UoM-Robotics-Society/MEng-Team-Project-Instruments/Final Report/Individual Parts/Josh/DSC_0120.JPG

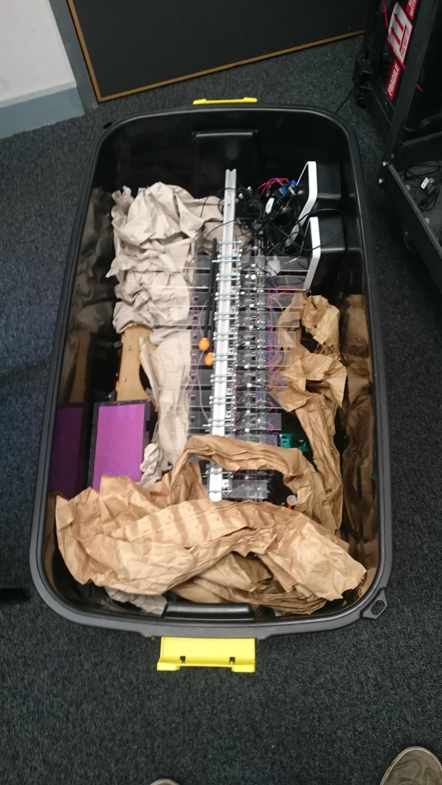
Final Report/Individual Parts/Josh/DSC_0120.JPG
