UoM-Robotics-Society/MEng-Team-Project-Instruments/Interim Report/Figure Source files/Andrei/A4988.PNG

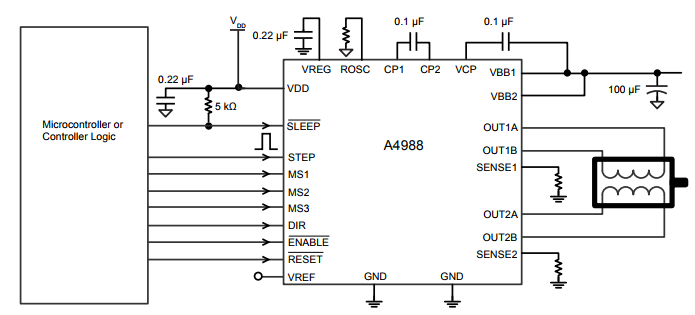
Interim Report/Figure Source files/Andrei/A4988.PNG
