UoM-Robotics-Society/MEng-Team-Project-Instruments/Interim Report/Figure Source files/Francesco/ad9837breakout.PNG

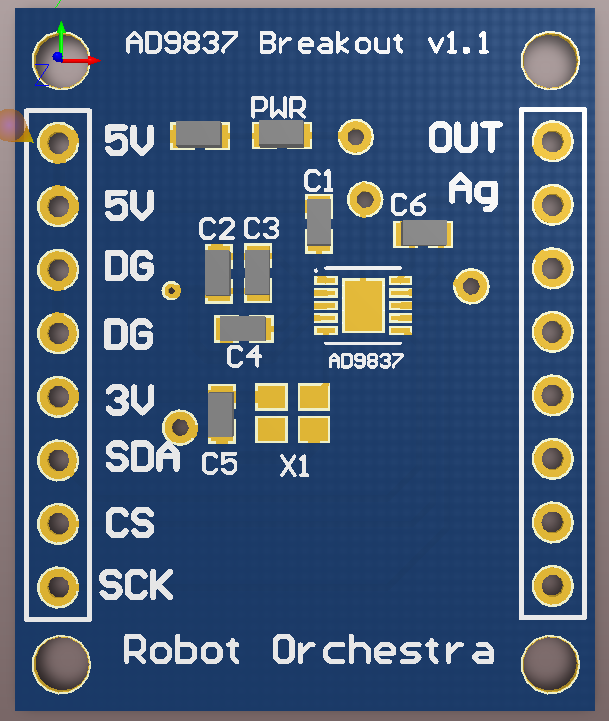
Interim Report/Figure Source files/Francesco/ad9837breakout.PNG
