UoM-Robotics-Society/MEng-Team-Project-Instruments/Interim Report/Figure Source files/Francesco/pcb2.PNG

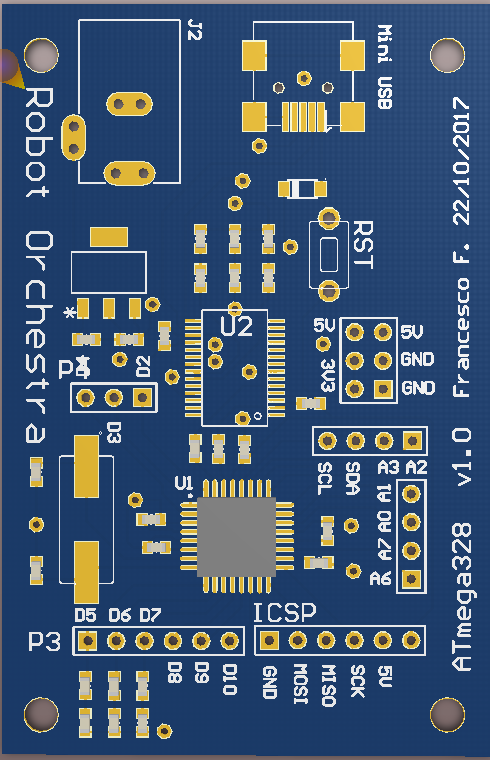
Interim Report/Figure Source files/Francesco/pcb2.PNG
