UoM-Robotics-Society/MEng-Team-Project-Instruments/Interim Report/Figure Source files/Josh/Figure 3.4 Robot playing flute-with lungs.png

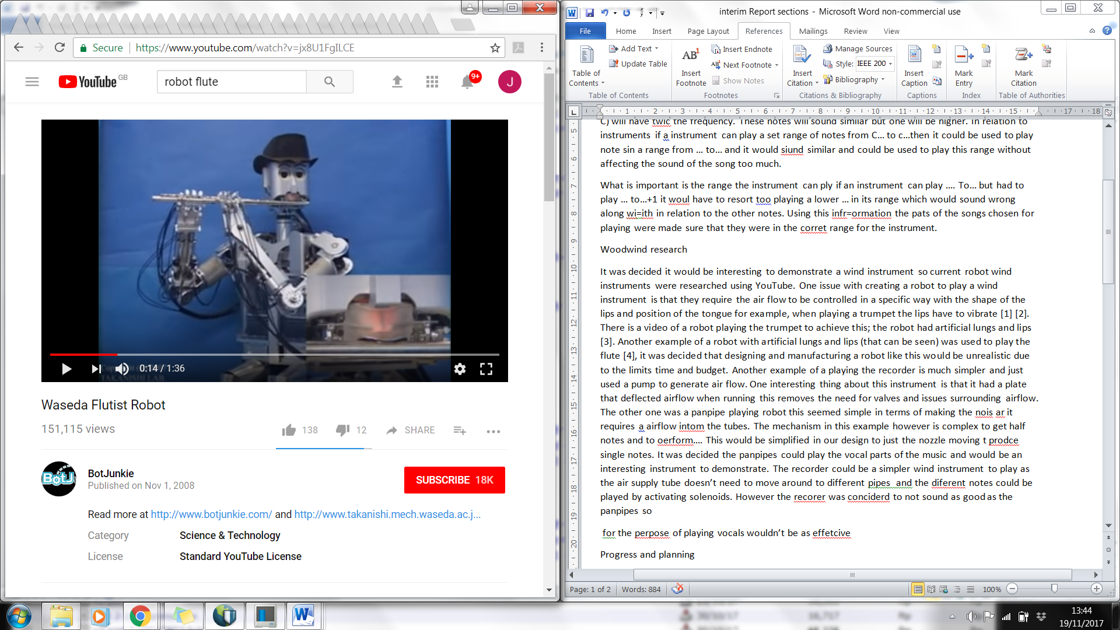
Interim Report/Figure Source files/Josh/Figure 3.4 Robot playing flute-with lungs.png
