UoM-Robotics-Society/MEng-Team-Project-Instruments/Interim Report/Figure Source files/Josh/Figure 3.5 Recorder Fingers.png

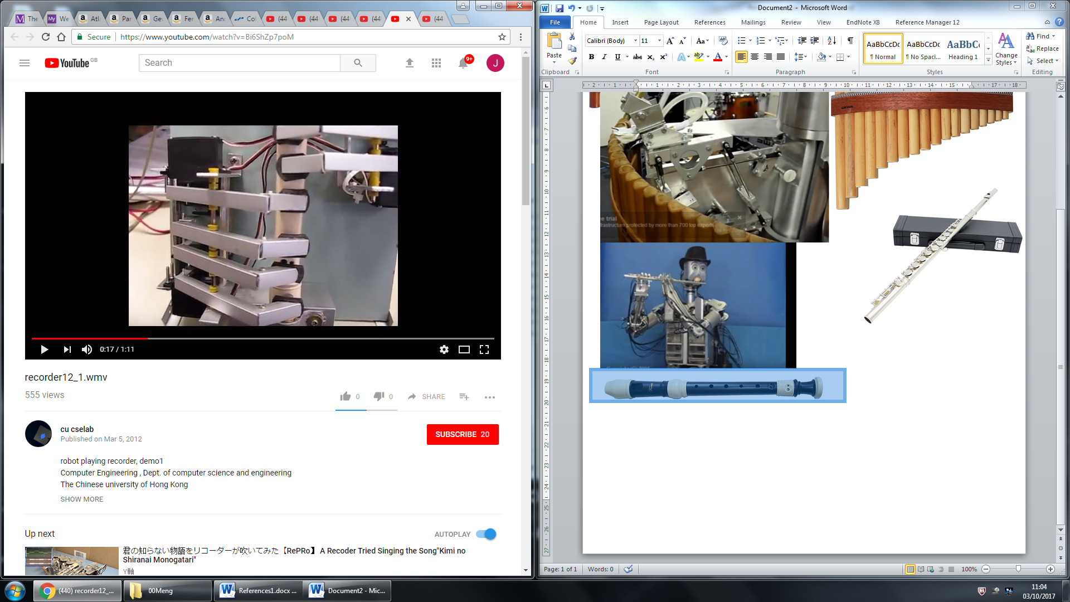
Interim Report/Figure Source files/Josh/Figure 3.5 Recorder Fingers.png
