UoM-Robotics-Society/MEng-Team-Project-Instruments/Interim Report/Figure Source files/Josh/Figure 3.5 Recorder nozzle.png

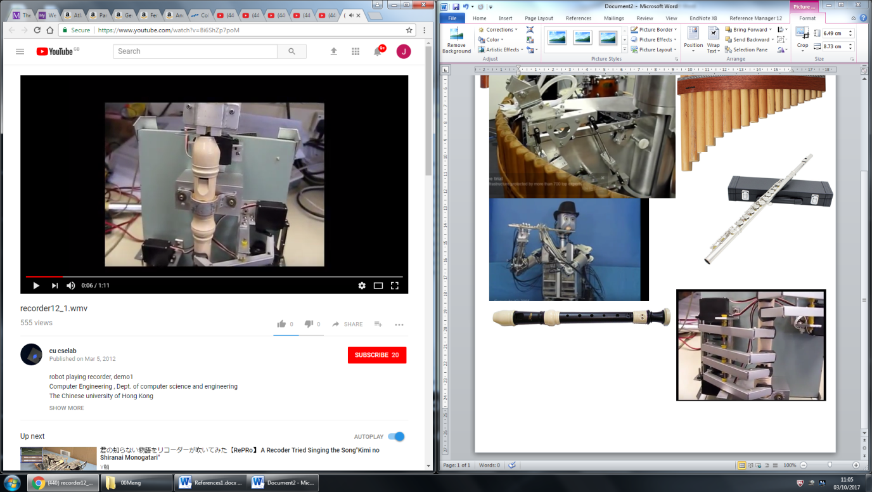
Interim Report/Figure Source files/Josh/Figure 3.5 Recorder nozzle.png
