UoM-Robotics-Society/MEng-Team-Project-Instruments/Interim Report/Figure Source files/Josh/Figure 3.6 Panpipes.png

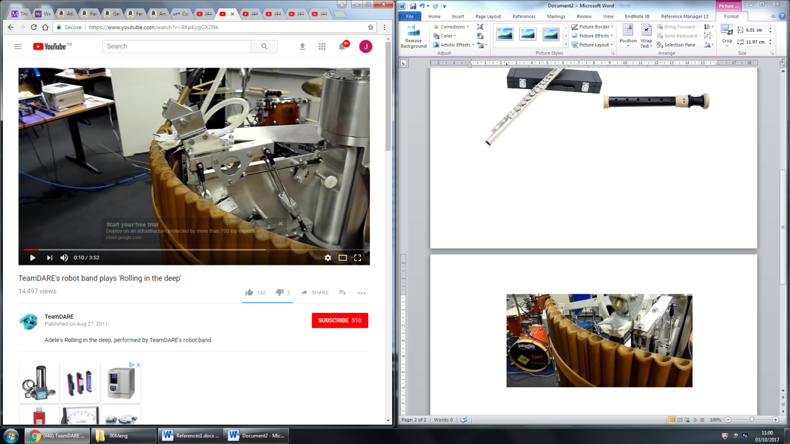
Interim Report/Figure Source files/Josh/Figure 3.6 Panpipes.png
