UoM-Robotics-Society/MEng-Team-Project-Instruments/Interim Report/Figure Source files/Josh/Figure 3.8 left hand image spark gap Tesla.png

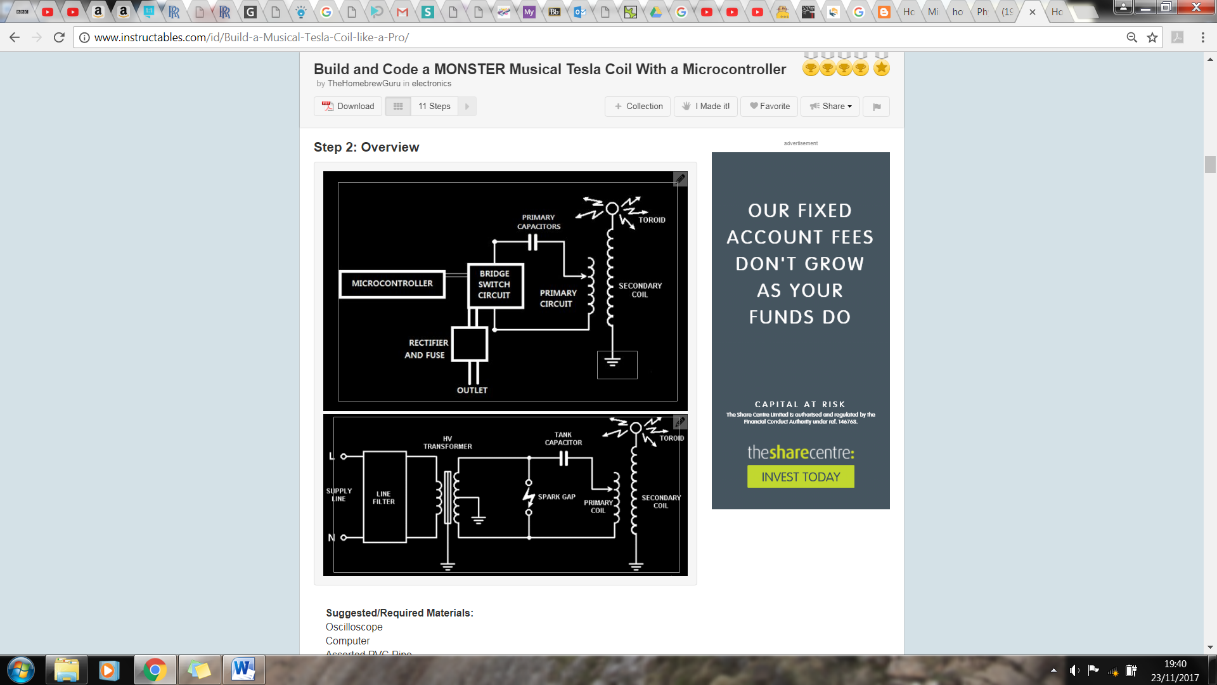
Interim Report/Figure Source files/Josh/Figure 3.8 left hand image spark gap Tesla.png
