UoM-Robotics-Society/MEng-Team-Project-Instruments/Interim Report/Figure Source files/Josh/Figure 3.9 Tesla Coil.png

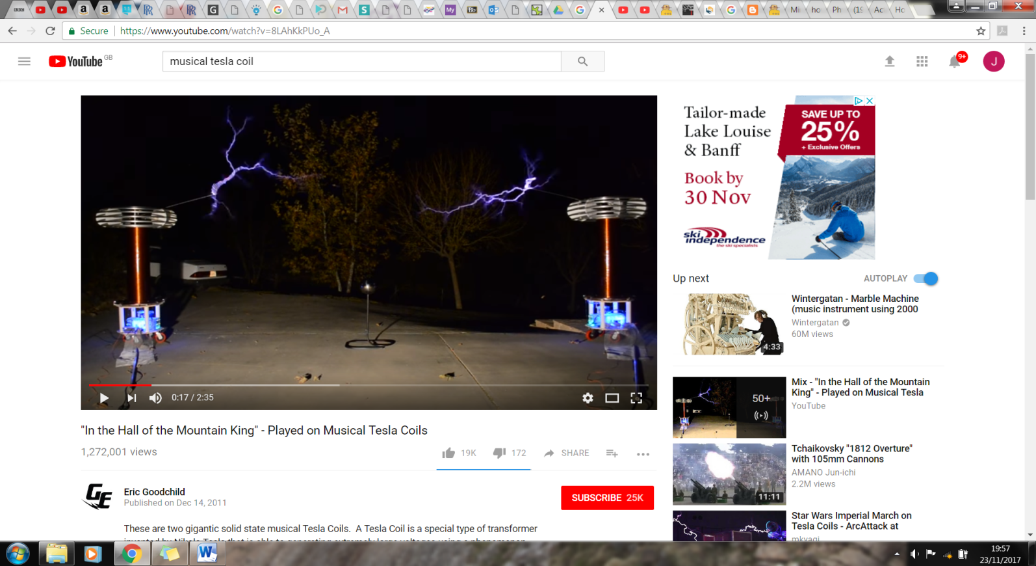
Interim Report/Figure Source files/Josh/Figure 3.9 Tesla Coil.png
