UoM-Robotics-Society/MEng-Team-Project-Instruments/Final Report/Individual Parts/Josh/DSC_0121.JPG

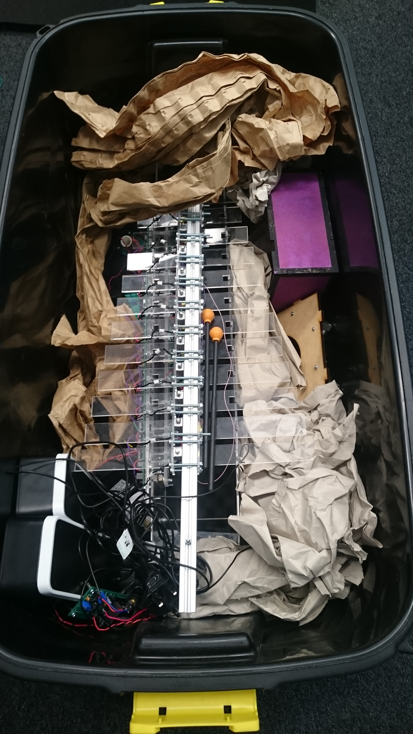
Final Report/Individual Parts/Josh/DSC_0121.JPG
