UoM-Robotics-Society/MEng-Team-Project-Instruments/CAD/Solidworks files/Stepper Box/Box1.SLDASM

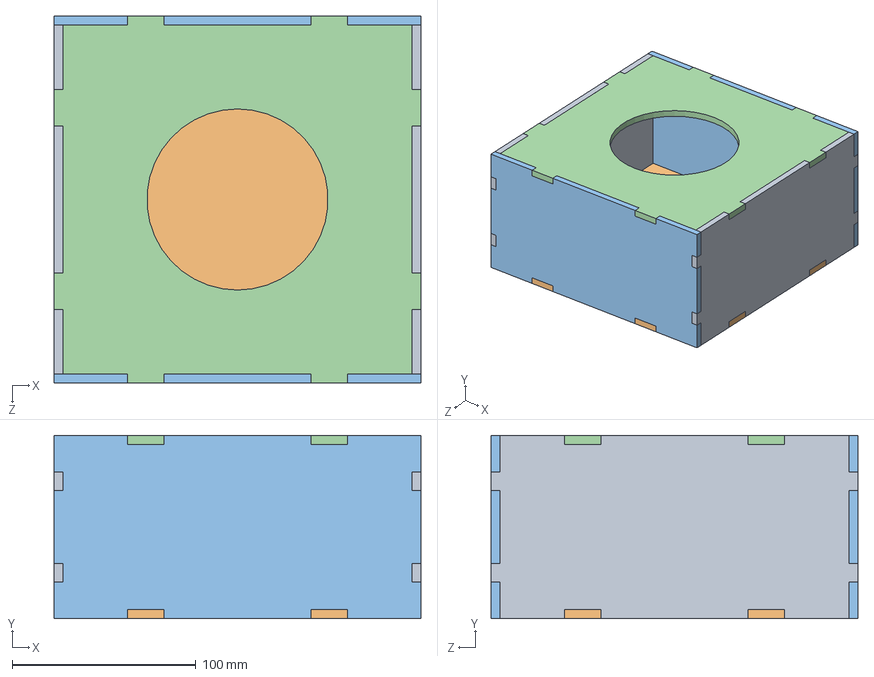
[picture p123: CAD file, 2022-08-24]
CAD/Solidworks files/Stepper Box/Box1.SLDASM
200.0 x 100.0 x 200.0 mm
Side1n3 x 2
BottomSide
Side2n4 x 2
Top
