UoM-Robotics-Society/MEng-Team-Project-Instruments/Interim Report/Figure Source files/Theo/xylophone assemblyv3/fullasemb.SLDASM

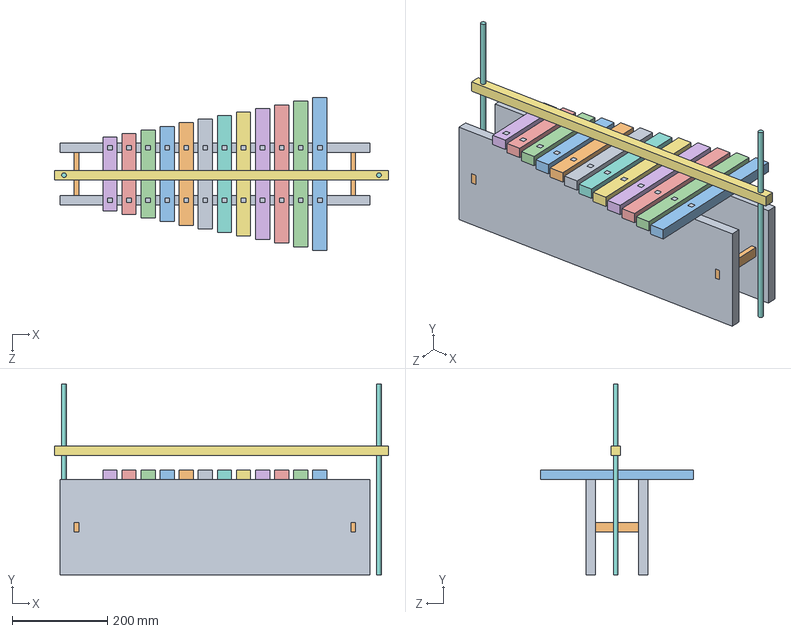
[picture p124: CAD file, 2022-08-24]
Interim Report/Figure Source files/Theo/xylophone assemblyv3/fullasemb.SLDASM
700.0 x 400.0 x 320.0 mm
front part v3 x 2
connecting rode x 2
bosch bar
threaded rod x 2
