UoM-Robotics-Society/MEng-Team-Project-Instruments/Interim Report/Figure Source files/Theo/xylophone assemblyv2/keys1.SLDASM

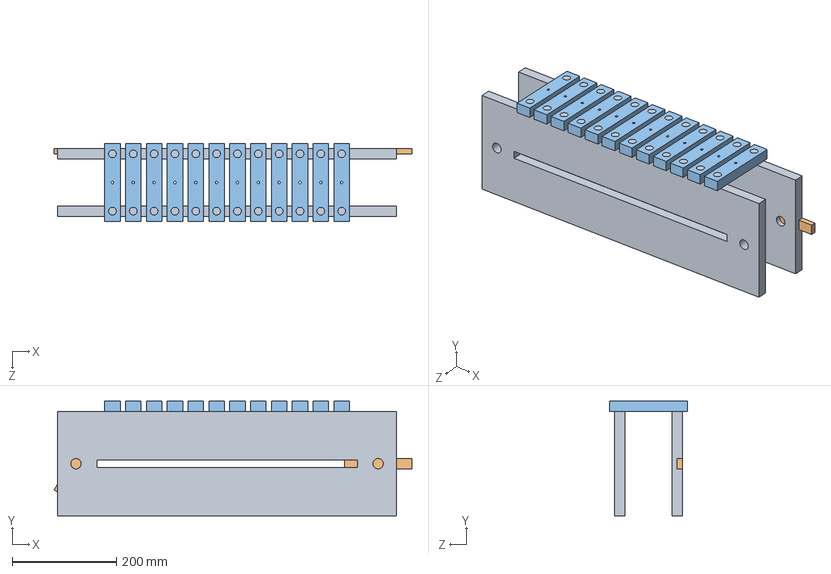
[picture p125: CAD file, 2022-08-24]
Interim Report/Figure Source files/Theo/xylophone assemblyv2/keys1.SLDASM
687.2 x 220.0 x 150.0 mm
front part x 2
connecting rode x 2
keys x 12
