UoM-Robotics-Society/MEng-Team-Project-Instruments/Interim Report/Figure Source files/Theo/xylophone assemblyv2/FullAssembly.SLDASM

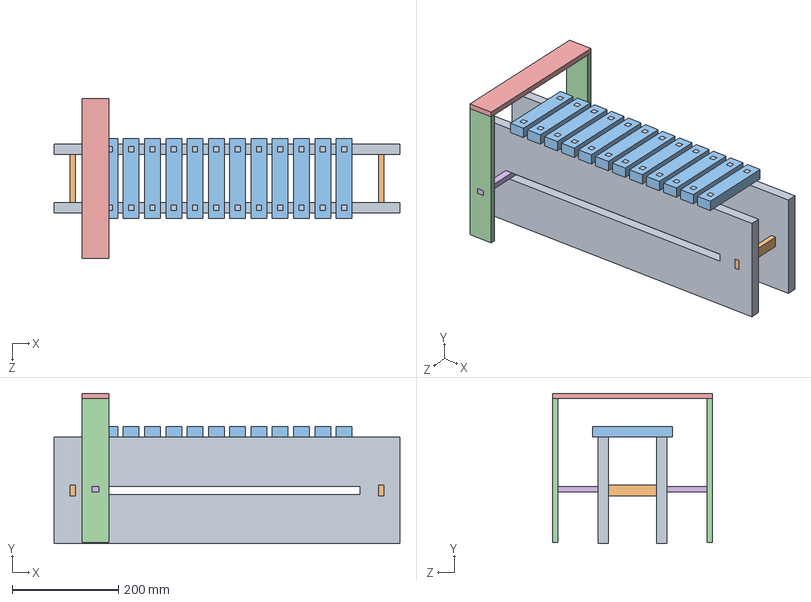
[picture p126: CAD file, 2022-08-24]
Interim Report/Figure Source files/Theo/xylophone assemblyv2/FullAssembly.SLDASM
650.0 x 282.5 x 300.0 mm
front part v2 x 2
connecting rode x 2
keysv2 x 12
piv2 x 2
toppartpi
rodpiv2
