UoM-Robotics-Society/MEng-Team-Project-Instruments/Interim Report/Figure Source files/Theo/xylophone assemblyv2/connecting rode.SLDPRT

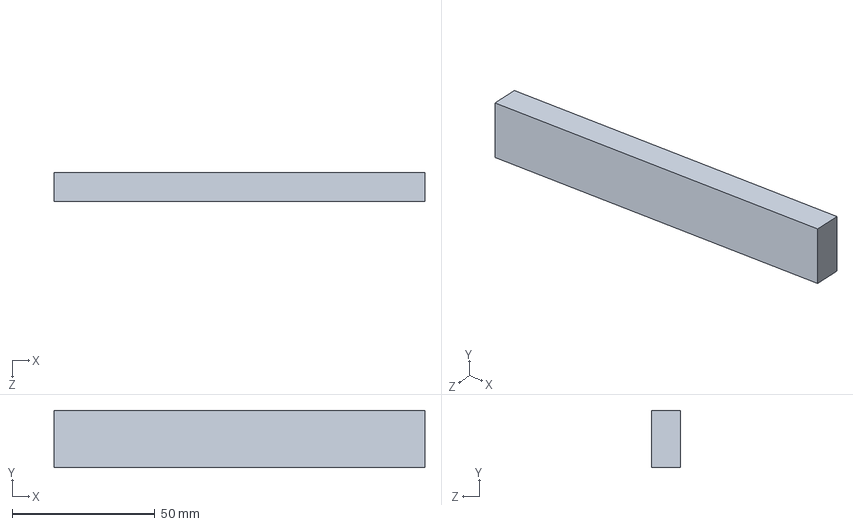
[picture p127: CAD file, 2022-08-24]
Interim Report/Figure Source files/Theo/xylophone assemblyv2/connecting rode.SLDPRT
130.0 x 20.0 x 10.0 mm
