UoM-Robotics-Society/MEng-Team-Project-Instruments/Interim Report/Figure Source files/Theo/xylophone assemblyv3/9.SLDPRT

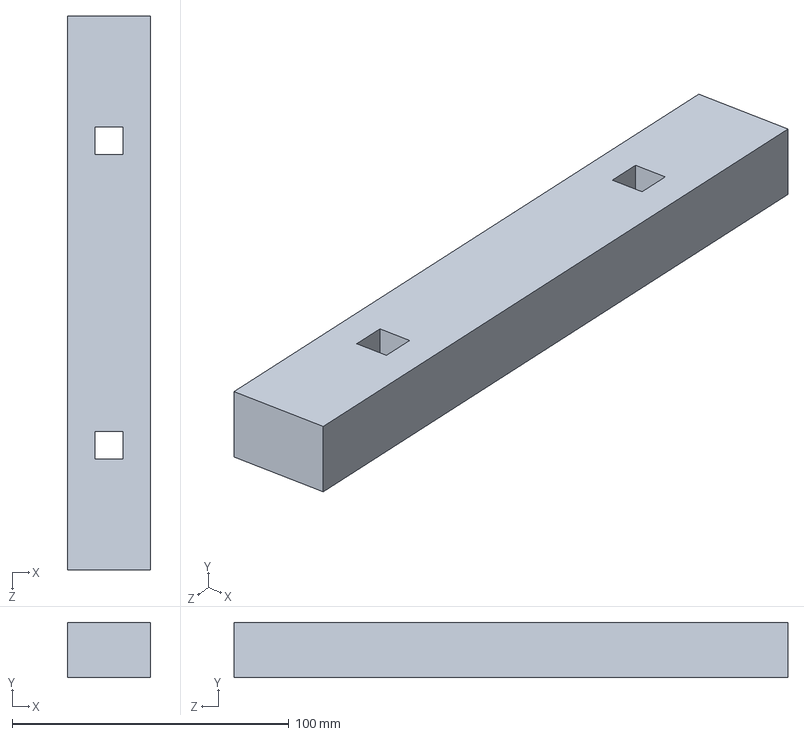
[picture p128: CAD file, 2022-08-24]
Interim Report/Figure Source files/Theo/xylophone assemblyv3/9.SLDPRT
30.0 x 20.0 x 200.0 mm
