UoM-Robotics-Society/MEng-Team-Project-Instruments/CAD/Solidworks files/Stepper Box/Side2.SLDPRT

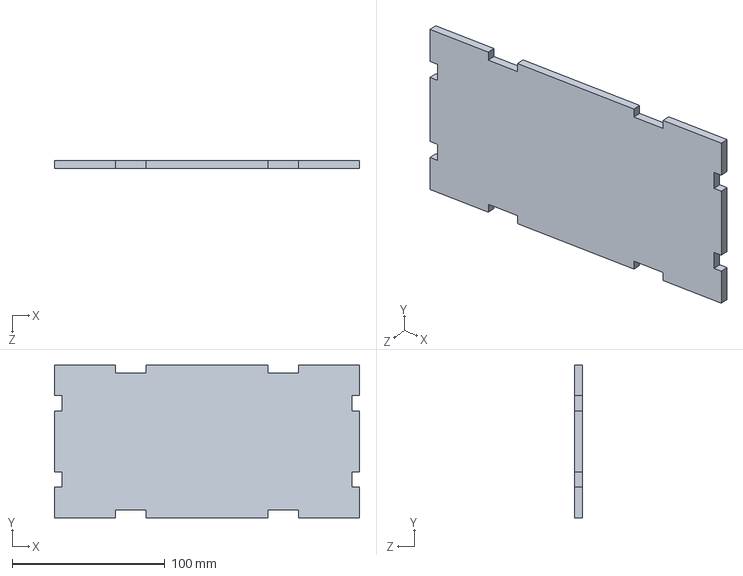
[picture p129: CAD file, 2022-08-24]
CAD/Solidworks files/Stepper Box/Side2.SLDPRT
200.0 x 100.0 x 5.00 mm
