UoM-Robotics-Society/MEng-Team-Project-Instruments/CAD/Solidworks files/Stepper Box/Side1.SLDPRT

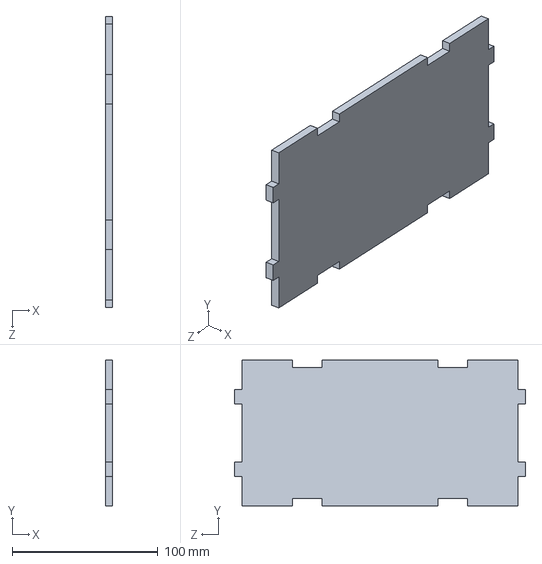
[picture p131: CAD file, 2022-08-24]
CAD/Solidworks files/Stepper Box/Side1.SLDPRT
5.00 x 100.0 x 200.0 mm
