UoM-Robotics-Society/MEng-Team-Project-Instruments/Interim Report/Figure Source files/Theo/xylophone assemblyv2/front part v2.SLDPRT

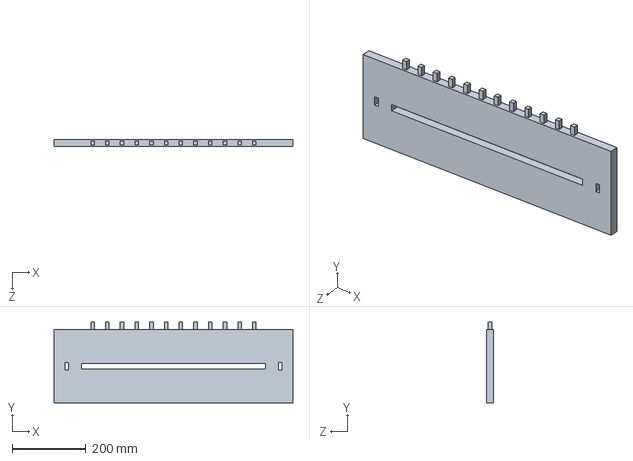
[picture p132: CAD file, 2022-08-24]
Interim Report/Figure Source files/Theo/xylophone assemblyv2/front part v2.SLDPRT
650.0 x 220.0 x 20.0 mm
