UoM-Robotics-Society/MEng-Team-Project-Instruments/Interim Report/Figure Source files/Theo/xylophone assemblyv3/11.SLDPRT

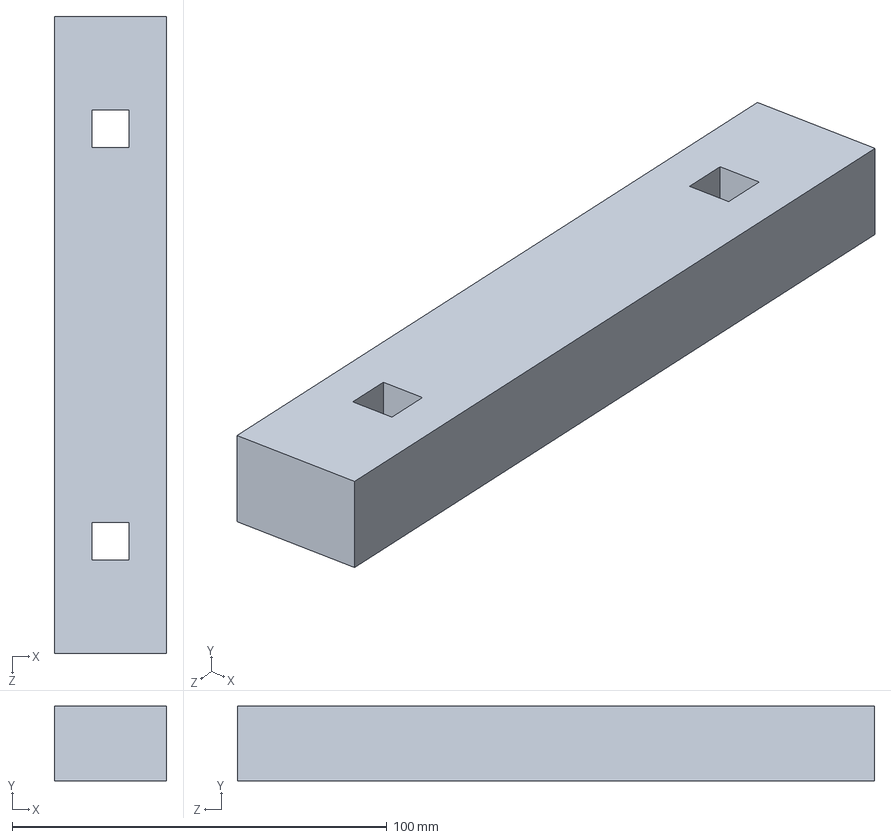
[picture p133: CAD file, 2022-08-24]
Interim Report/Figure Source files/Theo/xylophone assemblyv3/11.SLDPRT
30.0 x 20.0 x 170.0 mm
