UoM-Robotics-Society/MEng-Team-Project-Instruments/CAD/Solidworks files/Stepper Box/Top.SLDPRT

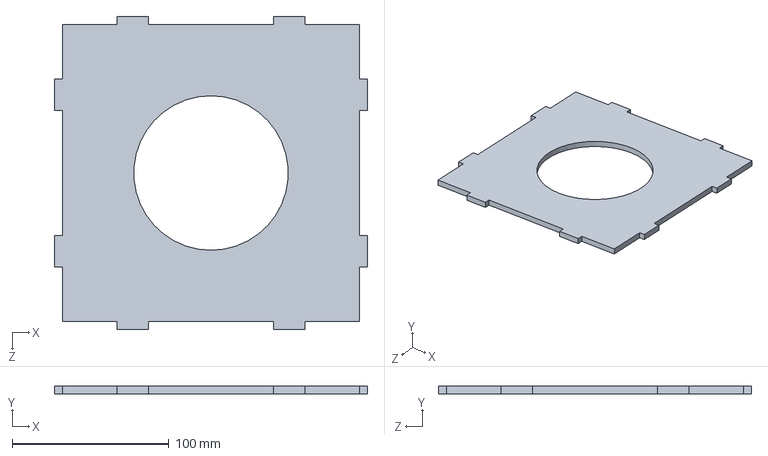
[picture p134: CAD file, 2022-08-24]
CAD/Solidworks files/Stepper Box/Top.SLDPRT
200.0 x 5.00 x 200.0 mm
