UoM-Robotics-Society/MEng-Team-Project-Instruments/Interim Report/Figure Source files/Theo/xylophone assemblyv2/keysv2.SLDPRT

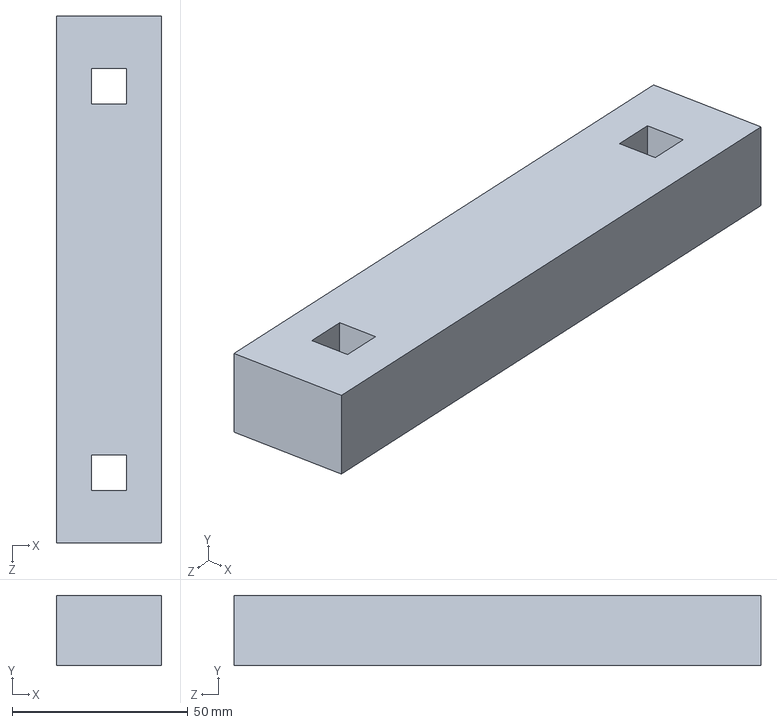
[picture p135: CAD file, 2022-08-24]
Interim Report/Figure Source files/Theo/xylophone assemblyv2/keysv2.SLDPRT
30.0 x 20.0 x 150.0 mm
