UoM-Robotics-Society/MEng-Team-Project-Instruments/Interim Report/Figure Source files/Theo/xylophone assemblyv3/6.SLDPRT

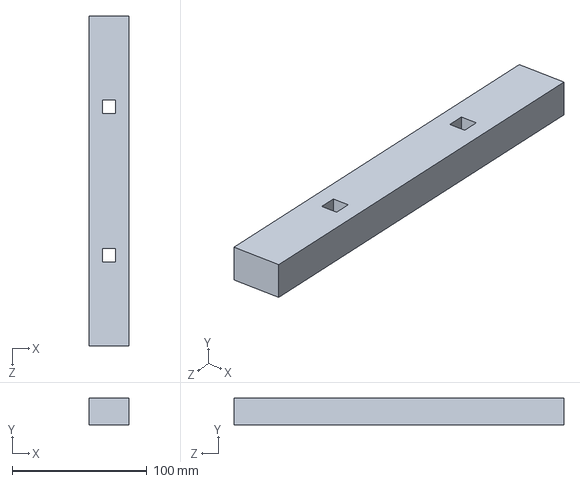
[picture p136: CAD file, 2022-08-24]
Interim Report/Figure Source files/Theo/xylophone assemblyv3/6.SLDPRT
30.0 x 20.0 x 245.0 mm
