UoM-Robotics-Society/MEng-Team-Project-Instruments/Interim Report/Figure Source files/Theo/xylophone assemblyv3/8.SLDPRT

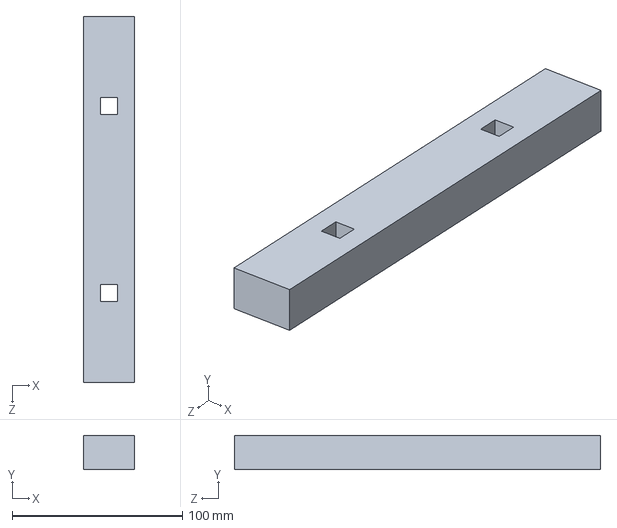
[picture p137: CAD file, 2022-08-24]
Interim Report/Figure Source files/Theo/xylophone assemblyv3/8.SLDPRT
30.0 x 20.0 x 215.0 mm
