UoM-Robotics-Society/MEng-Team-Project-Instruments/Interim Report/Figure Source files/Theo/xylophone assemblyv2/bearing.SLDPRT

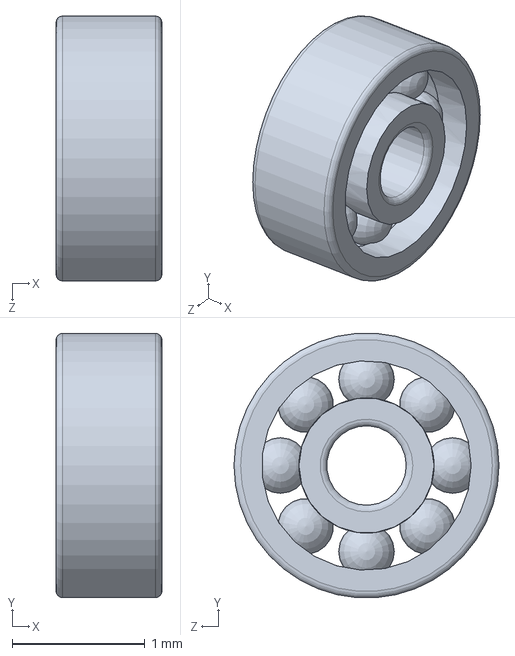
[picture p138: CAD file, 2022-08-24]
Interim Report/Figure Source files/Theo/xylophone assemblyv2/bearing.SLDPRT
0.8 x 1.99 x 2.00 mm
