UoM-Robotics-Society/MEng-Team-Project-Instruments/Interim Report/Figure Source files/Theo/xylophone assemblyv3/12.SLDPRT

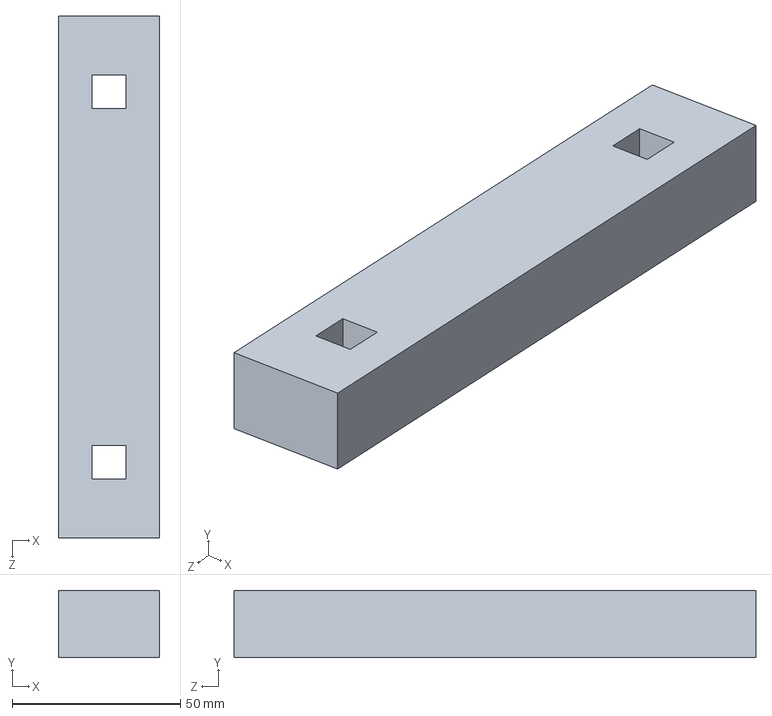
[picture p139: CAD file, 2022-08-24]
Interim Report/Figure Source files/Theo/xylophone assemblyv3/12.SLDPRT
30.0 x 20.0 x 155.0 mm
