UoM-Robotics-Society/MEng-Team-Project-Instruments/Interim Report/Figure Source files/Theo/xylophone assemblyv2/pi.SLDPRT

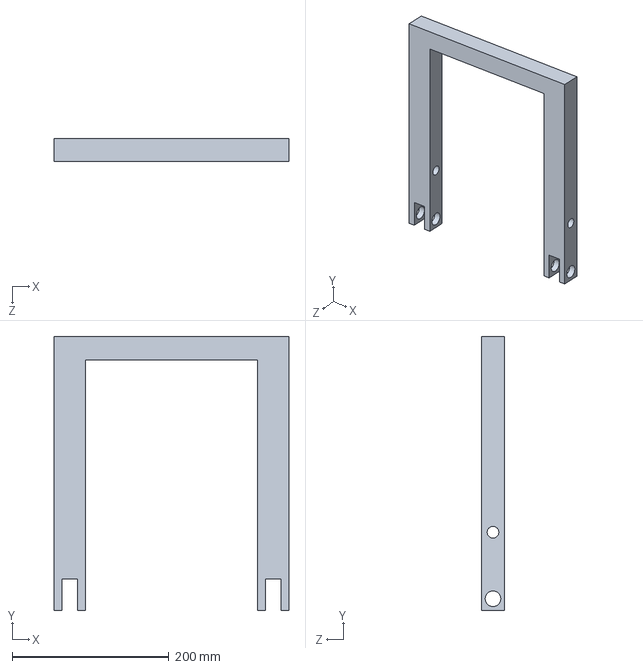
[picture p140: CAD file, 2022-08-24]
Interim Report/Figure Source files/Theo/xylophone assemblyv2/pi.SLDPRT
300.0 x 350.0 x 30.0 mm
