UoM-Robotics-Society/MEng-Team-Project-Instruments/Interim Report/Figure Source files/Theo/xylophone assemblyv3/threaded rod.SLDPRT

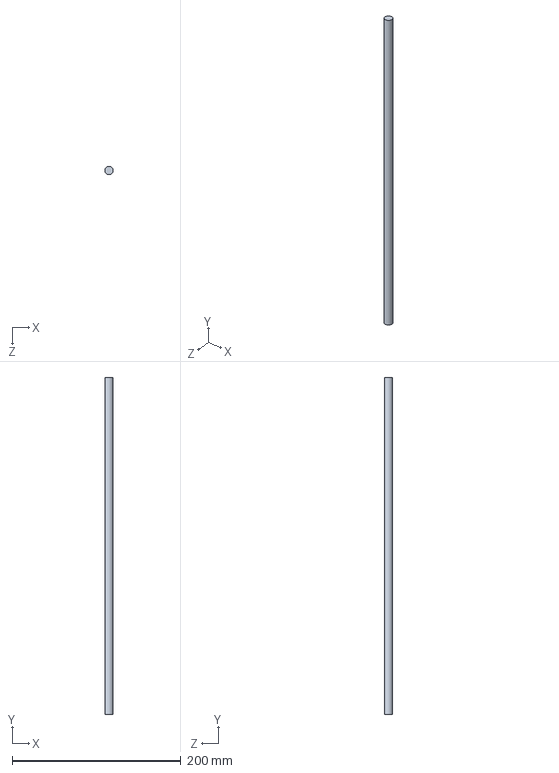
[picture p141: CAD file, 2022-08-24]
Interim Report/Figure Source files/Theo/xylophone assemblyv3/threaded rod.SLDPRT
10.0 x 400.0 x 10.0 mm
