UoM-Robotics-Society/MEng-Team-Project-Instruments/Interim Report/Figure Source files/Theo/xylophone assemblyv2/toppartpi.SLDPRT

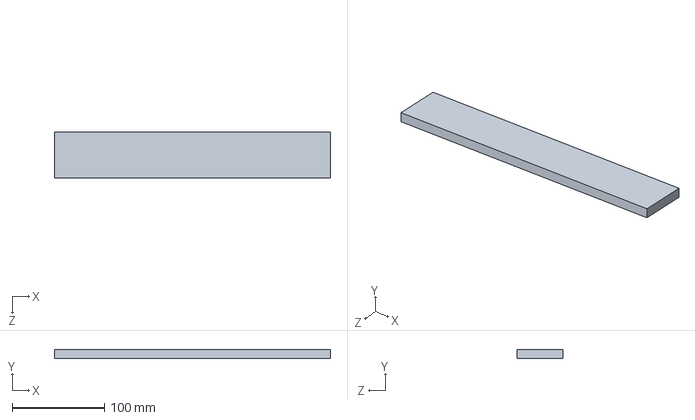
[picture p142: CAD file, 2022-08-24]
Interim Report/Figure Source files/Theo/xylophone assemblyv2/toppartpi.SLDPRT
300.0 x 10.0 x 50.0 mm
