UoM-Robotics-Society/MEng-Team-Project-Instruments/Interim Report/Figure Source files/Theo/xylophone assemblyv3/4.SLDPRT

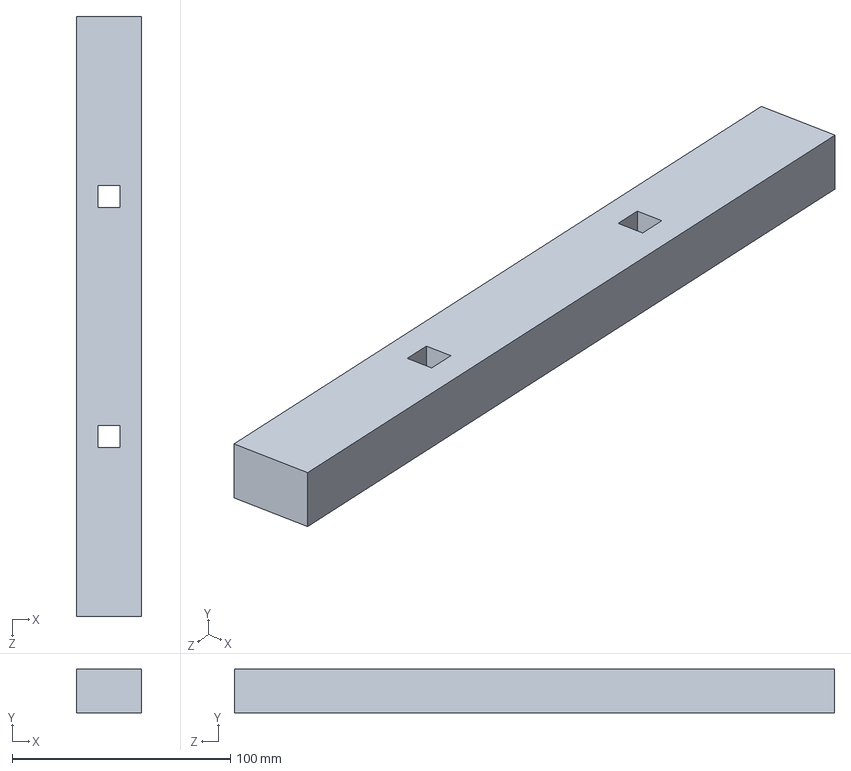
[picture p143: CAD file, 2022-08-24]
Interim Report/Figure Source files/Theo/xylophone assemblyv3/4.SLDPRT
30.0 x 20.0 x 275.0 mm
