UoM-Robotics-Society/MEng-Team-Project-Instruments/Interim Report/Figure Source files/Theo/xylophone assemblyv2/piv2.SLDPRT

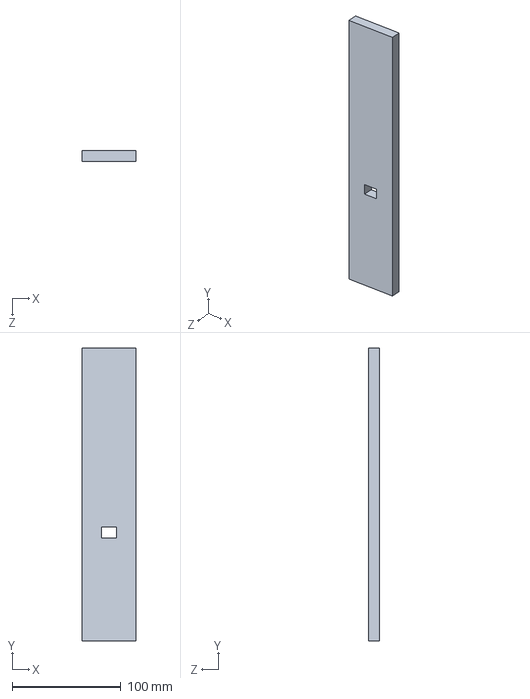
[picture p144: CAD file, 2022-08-24]
Interim Report/Figure Source files/Theo/xylophone assemblyv2/piv2.SLDPRT
50.0 x 270.0 x 10.0 mm
