UoM-Robotics-Society/MEng-Team-Project-Instruments/(list of files, cad)

Other CAD files:
Interim Report/Figure Source files/Anton/Panpipes3.skp
