UoM-Robotics-Society/MEng-Team-Project-Instruments/CAD/Altium/a4988/a4988_Sheet.pdf

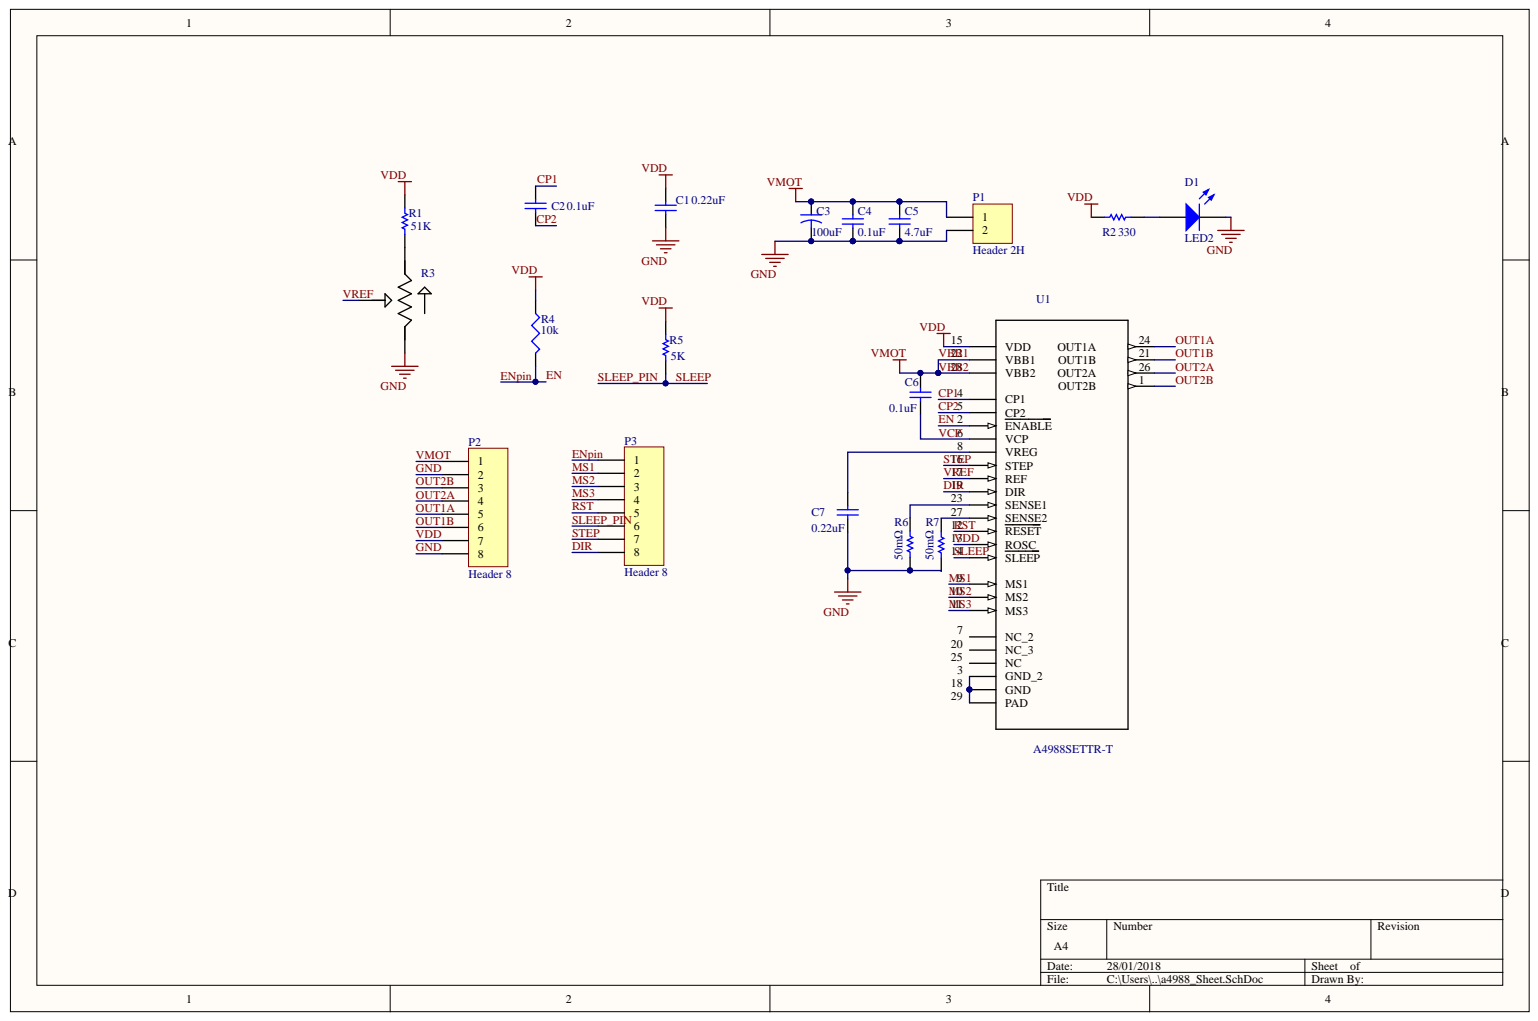
[picture p145: page 1]

Comment | Description | Designator | Footprint | LibRef | Quantity
Cap | Capacitor | C1, C2, C4, C5, C6 | RAD-0.3 | Cap | 5
Cap2 | Capacitor | C3 | CAPR5-4X5 | Cap2 | 1
| Capacitor | C7 | RAD-0.3 | Cap | 1
LED2 | Typical RED, GREEN, YELLOW, AMBER GaAs LED | D1 | 3.2X1.6X1.1 | LED2 | 1
Header 2H | Header, 2-Pin, Right Angle | P1 | HDR1X2H | Header 2H | 1
Header 8 | Header, 8-Pin | P2, P3 | HDR1X8 | Header 8 | 2
| Resistor | R1, R6, R7 | AXIAL-0.3 | Res1 | 3
Res1 | Resistor | R2, R5 | AXIAL-0.3 | Res1 | 2
| TRIMMER 10K OHM 0.1W SMD | R3 | 35WR | TC33X-2-103E | 1
Res3 | Resistor | R4 | J1-0603 | Res3 | 1
A4988SETTR-T | IC MOTOR DRIVERU1 | | QFN50P500X50A4988SETTR-T | | 1
