UoM-Robotics-Society/MEng-Team-Project-Instruments/Interim Report/Figure Source files/Francesco/ArduinoSchematic.pdf

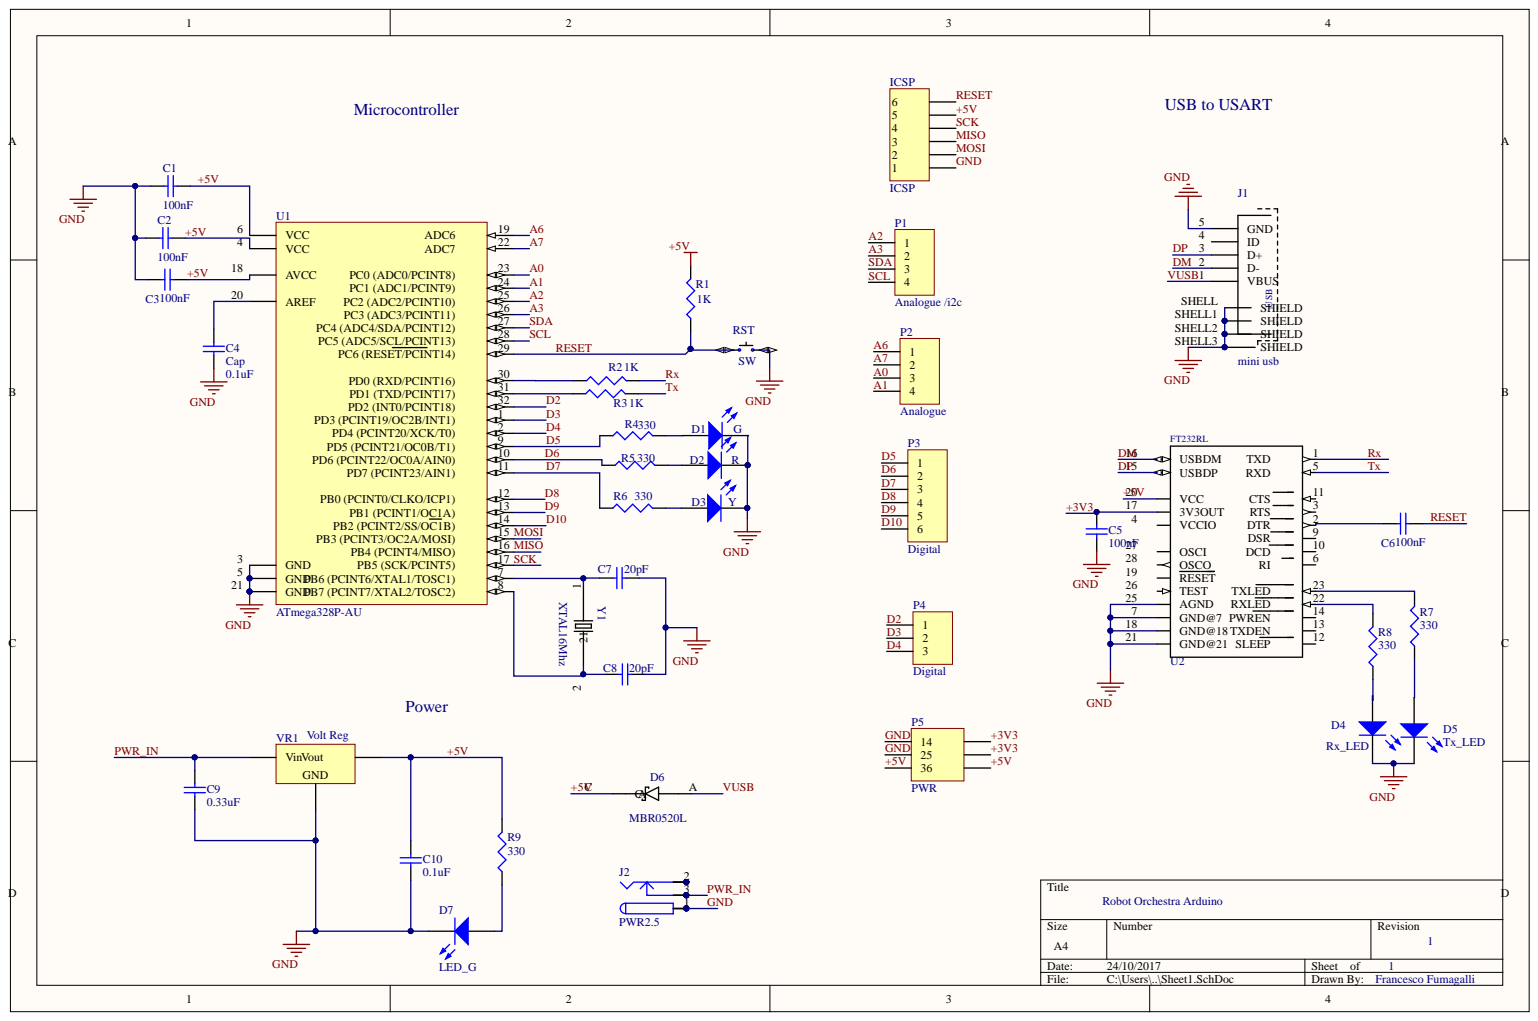
[picture p146: page 1]
