UoM-Robotics-Society/MEng-Team-Project-Instruments/(list of files, drawings)

Other design files:
CAD/Altium/New Piezo Comp/ComparatorV2.PcbDoc
CAD/Altium/New Piezo Comp/ComparatorV2Prj.PrjPCB
CAD/Altium/New Piezo Comp/Sheet2.SchDoc
CAD/Altium/Piezo Comparator/Comparator.PcbDoc
CAD/Altium/Piezo Comparator/Comparator_5.PcbDoc
CAD/Altium/Piezo Comparator/Sheet1.SchDoc
CAD/keyboard/180220.PcbDoc
CAD/Stepper Instrument PCB/Stepper PCB Correctionsv1.PcbDoc
Final Report/Individual Parts/Andrei/Stepper Teensy Breakout/Sheet1.SchDoc
Final Report/Individual Parts/Andrei/Stepper Teensy Breakout/Stepper Teensy Breakout p2.SchDoc
Final Report/Individual Parts/Andrei/Stepper Teensy Breakout/Stepper Teensy Breakout.PcbDoc
Final Report/Individual Parts/Andrei/Stepper Teensy Breakout/Stepper Teensy Breakout.PrjPcb
Final Report/Individual Parts/Andrei/Stepper Teensy Breakout/Stepper Teensy Breakout.SchDoc
Interim Report/Figure Source files/Andrei/connecting diagram.fzz
Interim Report/Figure Source files/Francesco/AD9837Final.PcbDoc
Interim Report/Figure Source files/Francesco/francesco_fumagalli_atmega328_final.PcbDoc
