UoM-Robotics-Society/MEng-Team-Project-Instruments/Software/theSoundBytes/Tesla/driverSetup.ino

void driver_setup(void)
{
  pinMode(DIR, OUTPUT);
  pinMode(EN, OUTPUT);
  pinMode(STEP, OUTPUT);
  //  pinMode(MS1, OUTPUT);
  //  pinMode(MS2, OUTPUT);
  //  pinMode(MS3, OUTPUT);

  digitalWrite(EN, LOW); //enable the driver

  //full step 0,0,0
  //truth table in datasheet
  //  digitalWrite(MS1, LOW);
  //  digitalWrite(MS2, LOW);
  //  digitalWrite(MS3, LOW);
  digitalWrite(DIR, HIGH);

}
